vitaliichyhryn/cantor/case/cantor-pro-lp/cantor-pro-lp-v2-switch-plates.dxf

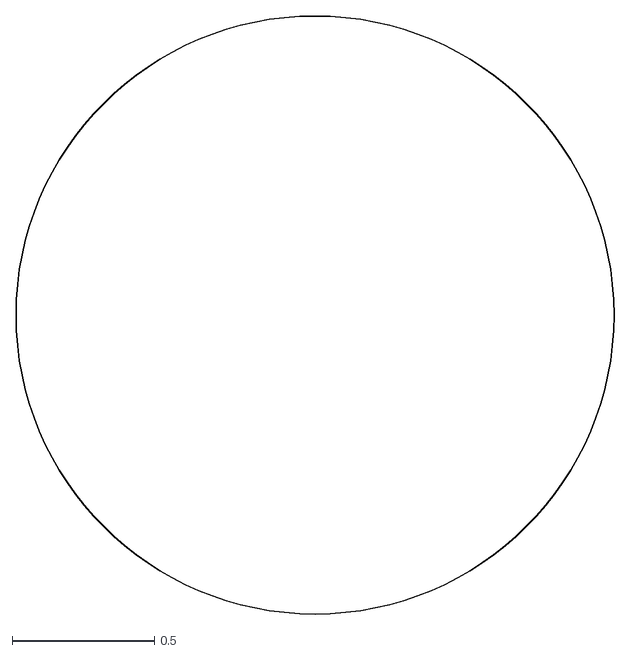
[picture p4: CAD file, 2024-04-05]
case/cantor-pro-lp/cantor-pro-lp-v2-switch-plates.dxf
2.10 x 2.10
