vitaliichyhryn/cantor/(list of files, cad)

Other CAD files:
case/cantor/cantor-switch-plates.dxf
case/cantor-pro-lp/cantor-pro-lp-v2-bottom-plates.dxf
case/cantor/cantor-bottom-plates.dxf
case/cantor-pro-lp/cantor-pro-lp-v2-mid-plates.dxf
case/cantor/cantor-switch-plates-no-standoffs.dxf
