vitaliichyhryn/cantor/(commit log)

2022-10-18 Add local footprint library
2022-10-18 Add holes for the brass standoffs
    [keyboard_pcb-rounded.kicad_pcb, keyboard_pcb.kicad_pcb, keyboard_pcb.kicad_sch]
2023-01-31 Add Cantor Pro version with Kailh Choc V1 hotswap sockets
    [cantor_pro_pcb.kicad_pcb, cantor_pro_pcb.kicad_sch]
2023-01-31 Add PCB switch plate
    [cantor_plate.kicad_pcb]
2023-01-31 Add acrylic switch and bottom plates
    [cantor-bottom-plates.dxf, cantor-switch-plates-no-standoffs.dxf, cantor-switch-plates.dxf]
2023-06-01 Add 42. Keebs KiCad library as a submodule
2023-06-01 Add footprint for a 3x6 tactile micro switch
2023-06-01 Add Cantor Pro Frood variation
    [pcb-pro-frood.kicad_pcb, pcb-pro-frood.kicad_sch]
2024-01-03 Use socket footprints with cutout outlines
    [pcb-pro-frood.kicad_pcb, pcb-pro-frood.kicad_sch]
2024-01-03 Add Cantor Pro Frood switch plate
    [cantor-pro-frood-switch-plate.kicad_pcb]
2024-01-03 Update 42. Keebs KiCad library
2024-01-03 Save one pin in TRRS, add RGB underglow
    [cantor-pro-frood-pcb.kicad_pcb, cantor-pro-frood-pcb.kicad_sch]
2024-01-03 Move controller down and modify outline to reduce empty space underneath
    [cantor-pro-frood-pcb.kicad_pcb, cantor-pro-frood-pcb.kicad_sch]
2024-02-22 Fix RGB underglow, switch to 2x12+5 Frood footprint
    [cantor-pro-frood-pcb.kicad_pcb, cantor-pro-frood-pcb.kicad_sch]
2024-04-05 Add acrylic case for the Cantor Pro Frood v2
    [cantor-bottom-plates.dxf, cantor-pro-frood-v2-bottom-plates.dxf, cantor-pro-frood-v2-mid-plates.dxf, cantor-pro-frood-v2-switch-plates.dxf, cantor-switch-plates-no-standoffs.dxf, cantor-switch-plates.dxf]
2025-03-27 Update the 42. Keebs KiCad library
2025-03-27 Add Cantor Pro MX v1.1
    [cantor-pro-mx-pcb.kicad_pcb, cantor-pro-mx-pcb.kicad_sch, cantor-pro-mx-plate.kicad_pcb]
2025-03-31 Update Cantor Pro Frood to v3.1
    * Support for Frood and nice!nano
    * Add battery contacts and power switch
    [cantor-pro-frood-pcb.kicad_pcb, cantor-pro-frood-pcb.kicad_sch, cantor-pro-mx-pcb.kicad_pcb, cantor-pro-mx-pcb.kicad_sch]
2025-03-31 Rename Cantor Pro Frood to Cantor Pro LP
    [cantor-pro-frood-switch-plate.kicad_pcb, cantor-pro-lp-pcb.kicad_pcb, cantor-pro-lp-pcb.kicad_sch, cantor-pro-lp-switch-plate.kicad_pcb, cantor-pro-lp-v2-bottom-plates.dxf, cantor-pro-lp-v2-mid-plates.dxf, cantor-pro-lp-v2-switch-plates.dxf]
2025-06-29 Remove LEDs
    [cantor-pro-mx-pcb.kicad_pcb, cantor-pro-mx-pcb.kicad_sch]
2025-06-29 Remove stray track
    [cantor-pro-mx-pcb.kicad_pcb]
2025-06-29 Remove stray via
    [cantor-pro-mx-pcb.kicad_pcb]
